iyedkouki/report/Assemblageboatvirsion2/Assemblageboatvirsion2+motors.SLDASM

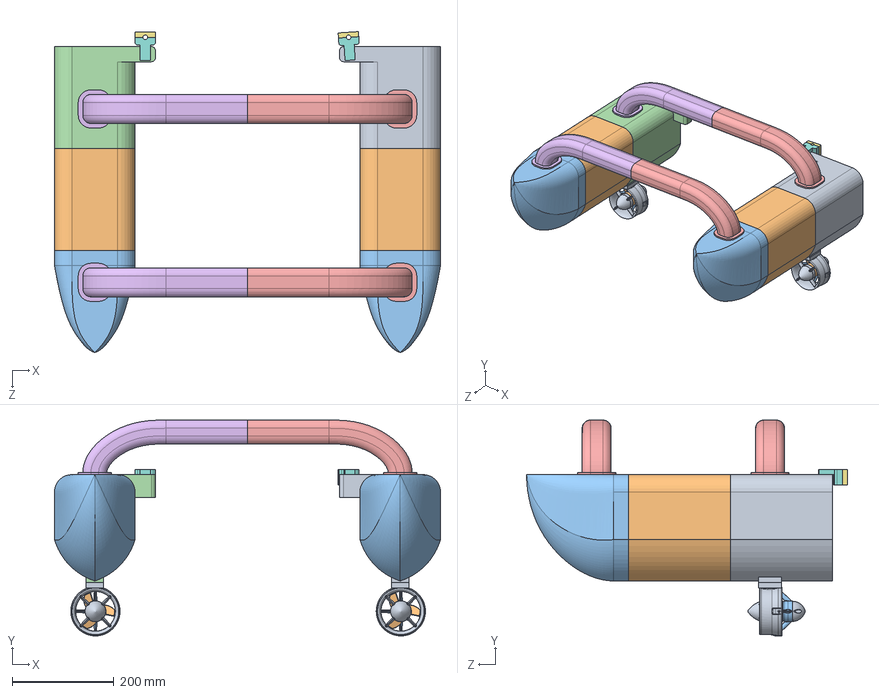
[picture p61: CAD file, 2025-06-13]
Assemblageboatvirsion2/Assemblageboatvirsion2+motors.SLDASM
757.0 x 423.3 x 629.2 mm
body_back_2
body_mid x 2
body_front x 2
body_back2
support_numero2 x 2
support_numero1 x 2
support_fillet2_virsion2 x 2
support_fillet1_virsion2 x 2
corps motor version 2 x 2
fans x 2
axe corps motor x 2
