iyedkouki/report/Assemblageboatvirsion2/Assemblagehull2.SLDASM

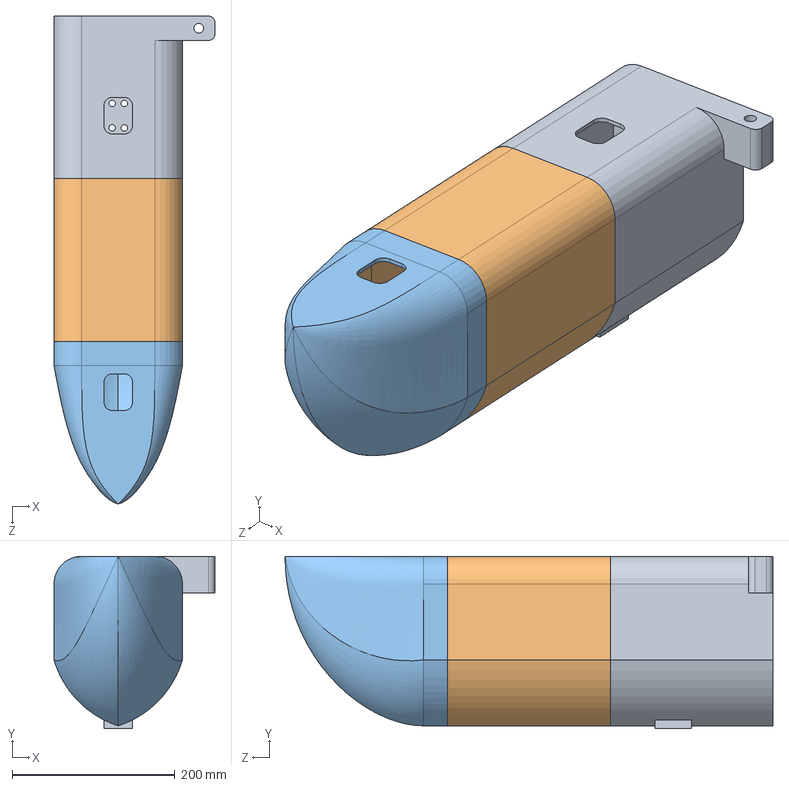
[picture p62: CAD file, 2025-06-13]
Assemblageboatvirsion2/Assemblagehull2.SLDASM
198.0 x 212.0 x 600.0 mm
body_back2
body_mid
body_front
