iyedkouki/report/Assemblageboatvirsion2/Assemblageboatvirsion2.SLDASM

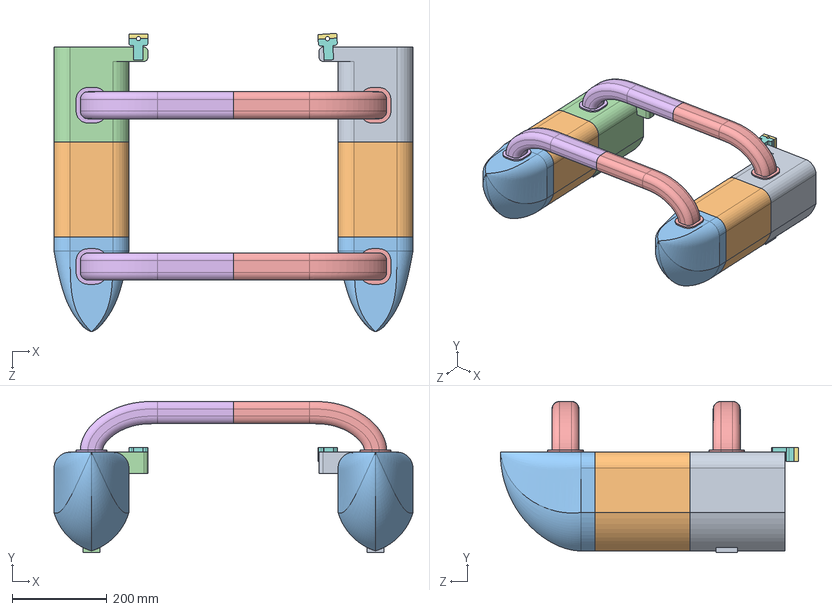
[picture p63: CAD file, 2025-06-13]
Assemblageboatvirsion2/Assemblageboatvirsion2.SLDASM
757.0 x 319.0 x 629.2 mm
body_back_2
body_mid x 2
body_front x 2
body_back2
support_numero2 x 2
support_numero1 x 2
support_fillet2_virsion2 x 2
support_fillet1_virsion2 x 2
