iyedkouki/report/Assemblageboatvirsion2/Assemblage_support.SLDASM

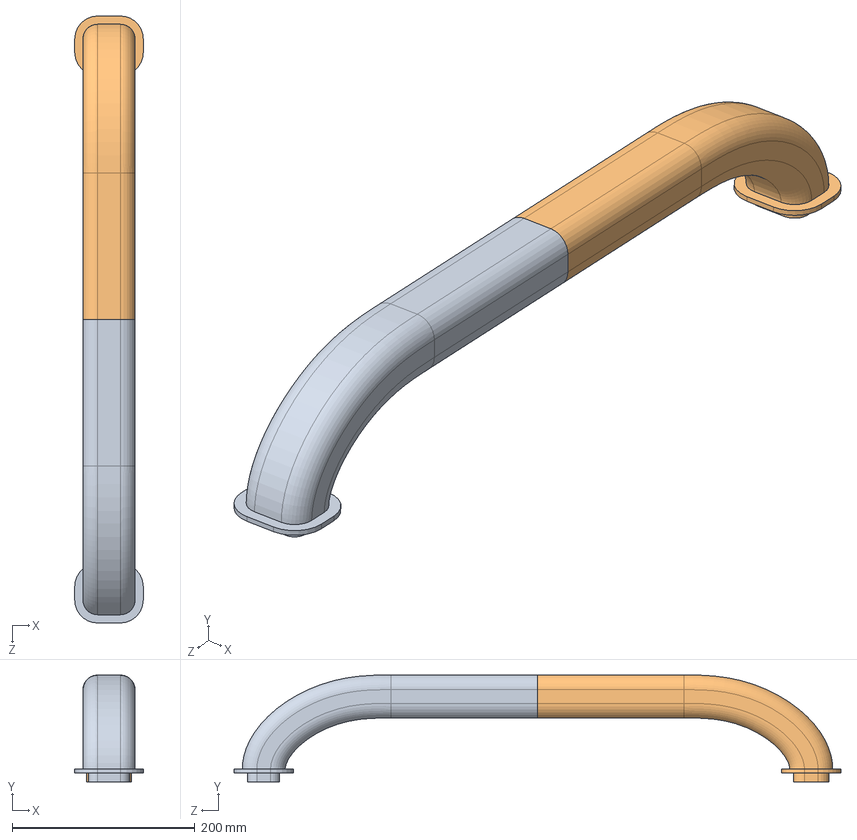
[picture p64: CAD file, 2025-06-13]
Assemblageboatvirsion2/Assemblage_support.SLDASM
75.0 x 117.0 x 664.0 mm
support_numero2
support_numero1
