iyedkouki/report/Assemblageboatvirsion2/Assemblage support fillet.SLDASM

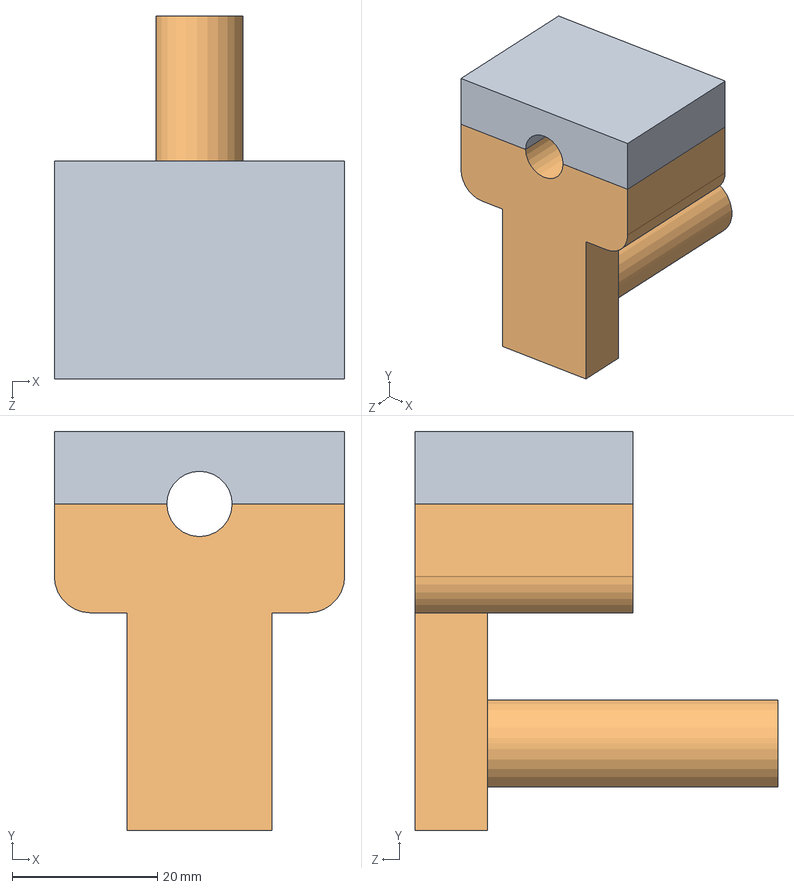
[picture p65: CAD file, 2025-06-13]
Assemblageboatvirsion2/Assemblage support fillet.SLDASM
40.0 x 55.0 x 50.0 mm
support_fillet2_virsion2
support_fillet1_virsion2
