iyedkouki/report/Assemblageboatvirsion2/body_mid.SLDPRT

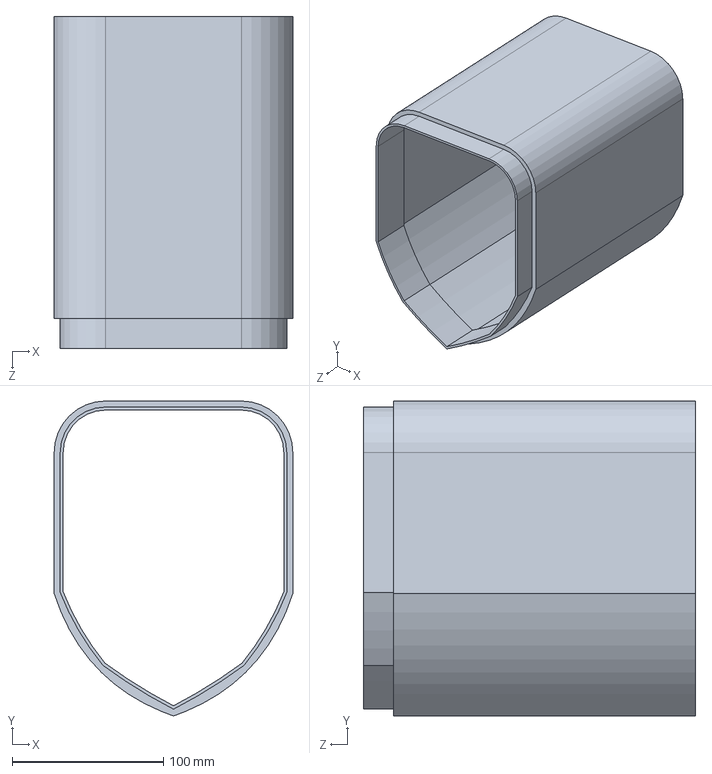
[picture p66: CAD file, 2025-06-13]
Assemblageboatvirsion2/body_mid.SLDPRT
158.0 x 208.5 x 220.0 mm
