iyedkouki/report/Assemblageboatvirsion2/body_front.SLDPRT

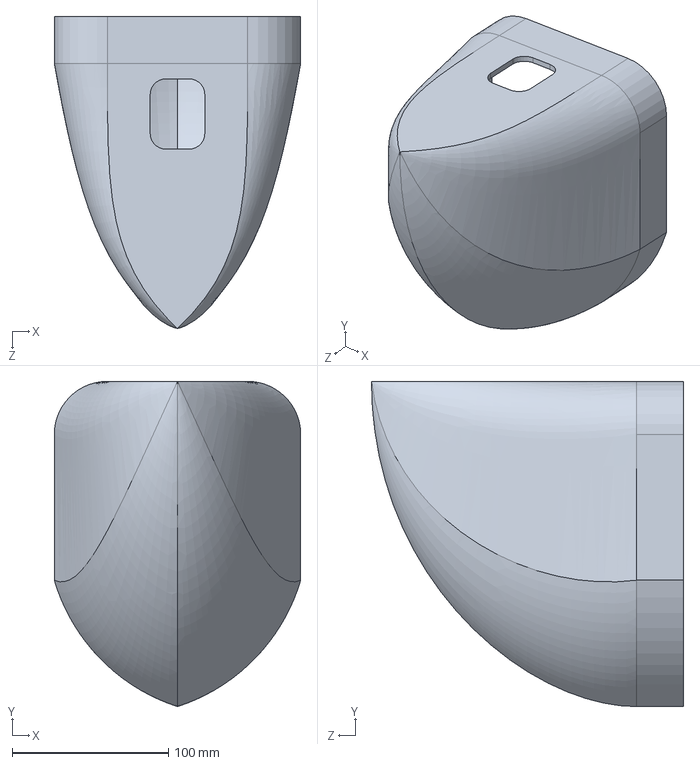
[picture p67: CAD file, 2025-06-13]
Assemblageboatvirsion2/body_front.SLDPRT
158.0 x 208.5 x 200.0 mm
