iyedkouki/report/Assemblageboatvirsion2/support_numero1.SLDPRT

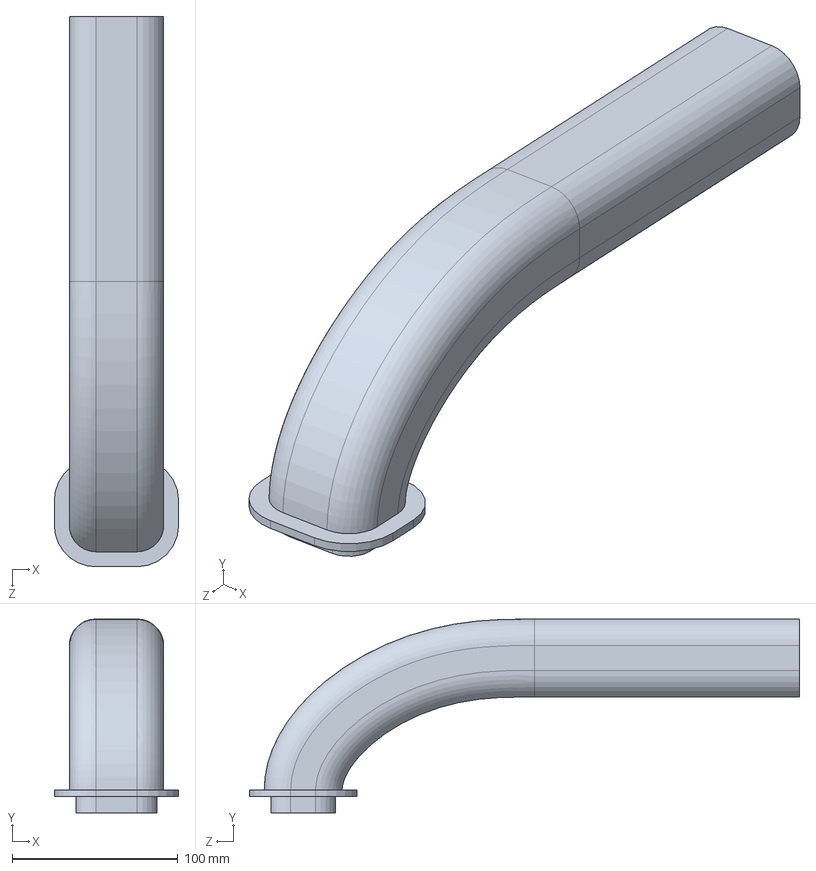
[picture p68: CAD file, 2025-06-13]
Assemblageboatvirsion2/support_numero1.SLDPRT
75.0 x 117.0 x 332.0 mm
