iyedkouki/report/Assemblageboatvirsion2/support_numero2.SLDPRT

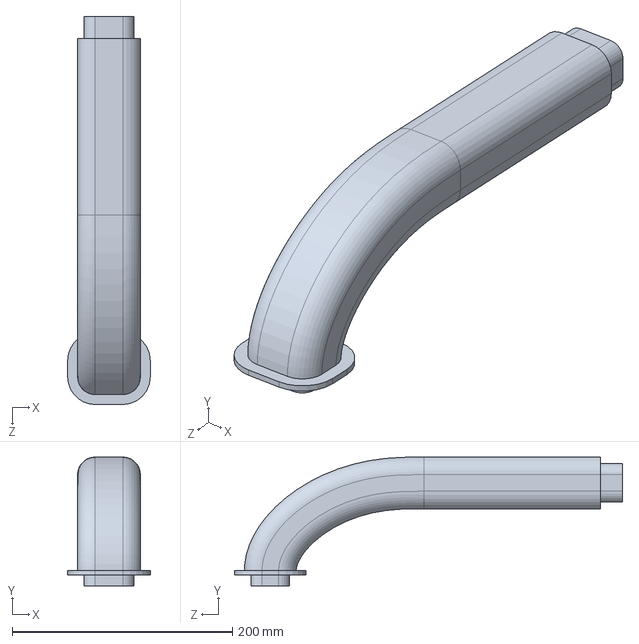
[picture p69: CAD file, 2025-06-13]
Assemblageboatvirsion2/support_numero2.SLDPRT
75.0 x 117.0 x 352.0 mm
