iyedkouki/report/Assemblageboatvirsion2/support_fillet2_virsion2.SLDPRT

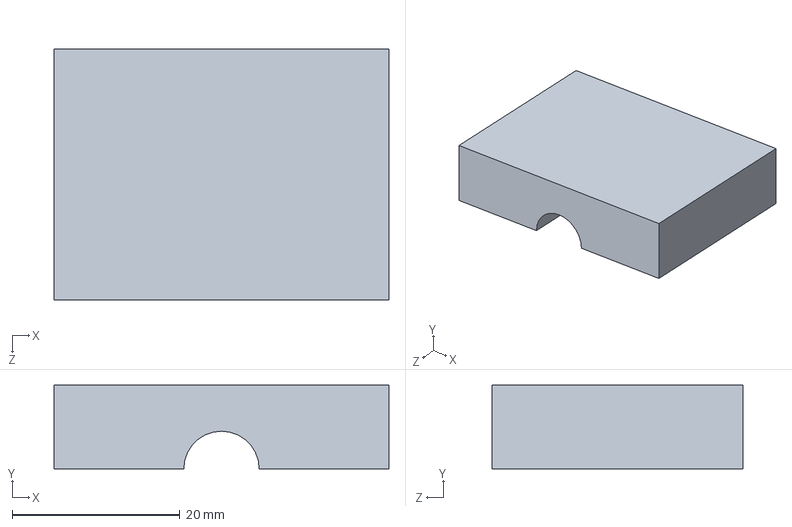
[picture p70: CAD file, 2025-06-13]
Assemblageboatvirsion2/support_fillet2_virsion2.SLDPRT
40.0 x 10.0 x 30.0 mm
