iyedkouki/report/Assemblageboatvirsion2/body_back2.SLDPRT

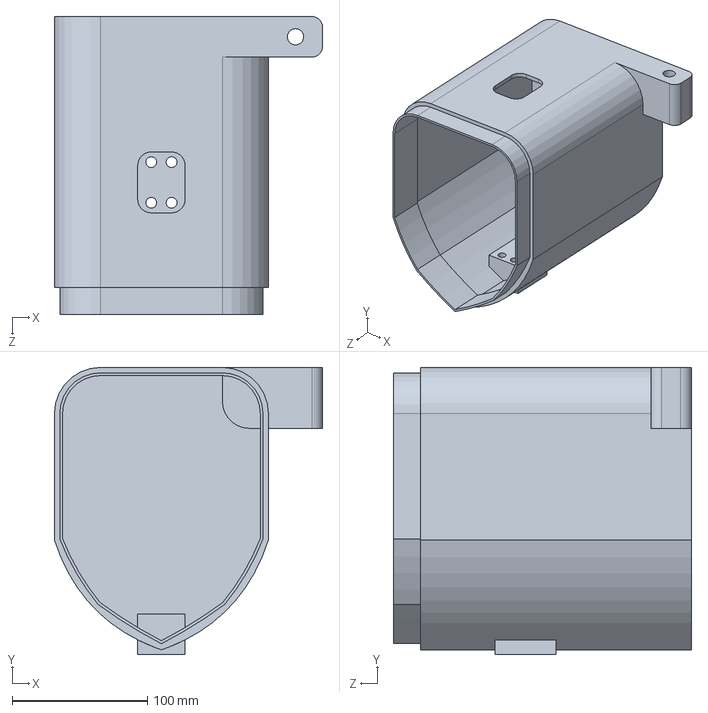
[picture p71: CAD file, 2025-06-13]
Assemblageboatvirsion2/body_back2.SLDPRT
198.0 x 212.0 x 220.0 mm
