iyedkouki/report/Assemblageboatvirsion2/support_fillet1_virsion2.SLDPRT

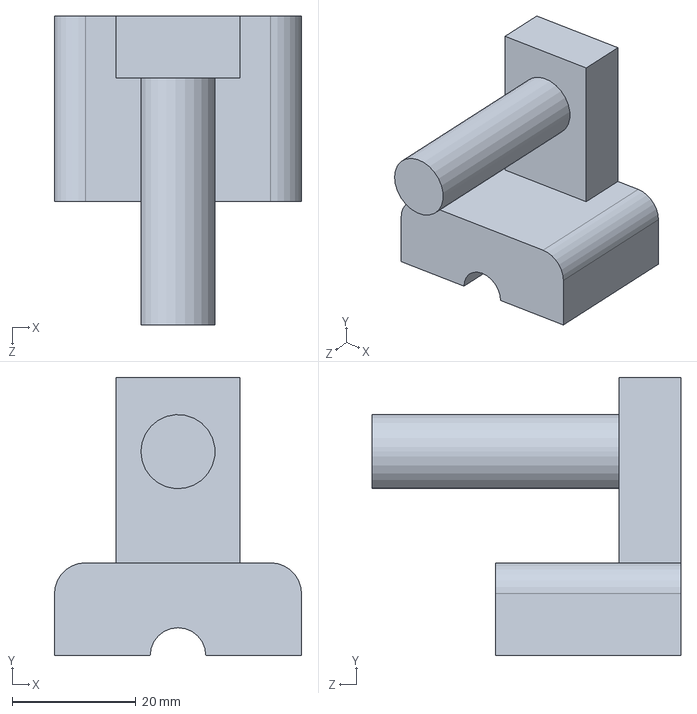
[picture p72: CAD file, 2025-06-13]
Assemblageboatvirsion2/support_fillet1_virsion2.SLDPRT
40.0 x 45.0 x 50.0 mm
