iyedkouki/report/(list of files, cad)

Other CAD files:
Assemblageboatvirsion2/Assemblagehull1.SLDASM
Assemblageboatvirsion2/body_back_2.SLDPRT
